EddieFranco/Home-Energy-Monitoring-Management-System/Images/Monitoring System block diagram.JPG

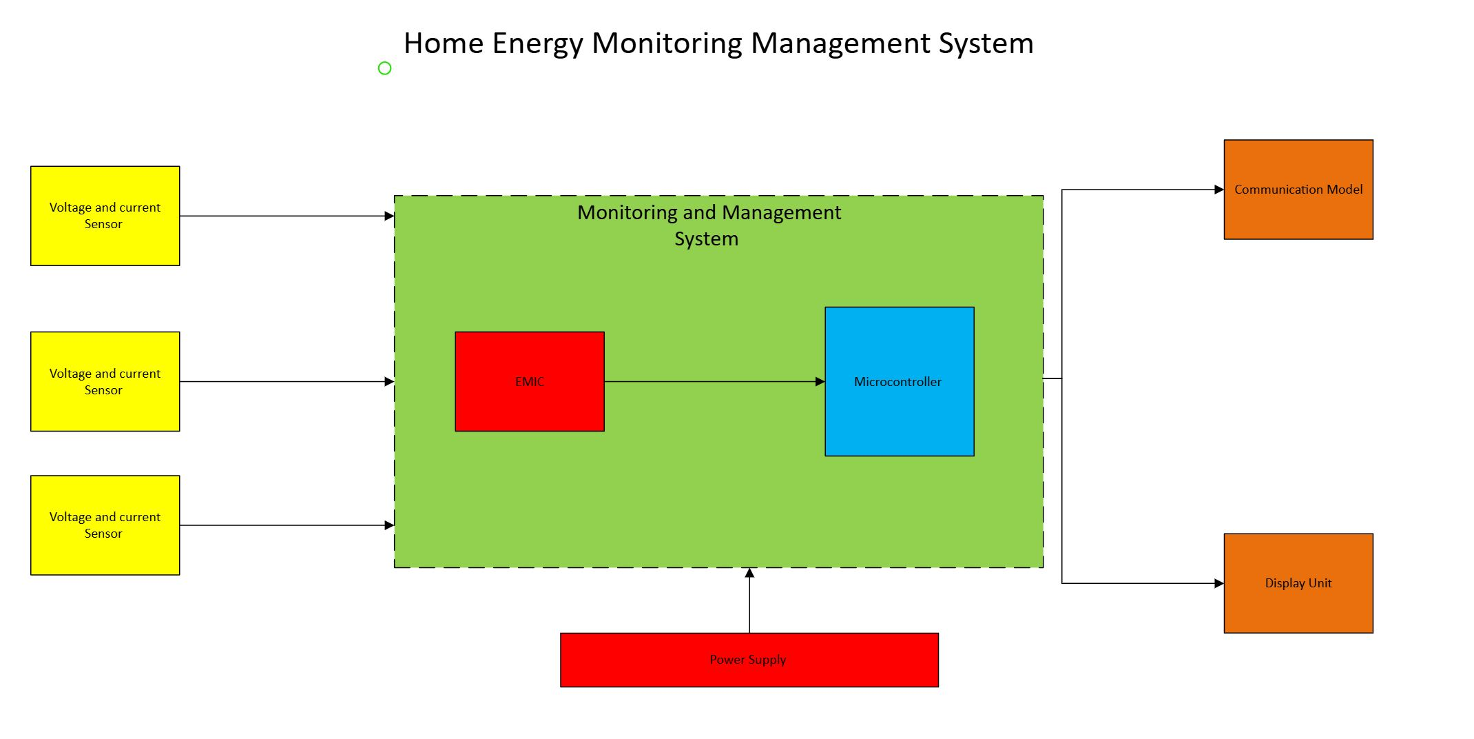
Images/Monitoring System block diagram.JPG
