EddieFranco/Home-Energy-Monitoring-Management-System/Water_Heat_Temp/Water_Heat_Temp.ioc

Mcu.UserName=STM32F407VGTx
PA0-WKUP.Signal=GPIO_Output
PA1.Signal=GPIO_Output
PB0.Signal=S_TIM3_CH3
PB1.Signal=S_TIM3_CH4
PB6.Signal=I2C1_SCL
PB7.Signal=I2C1_SDA
PD12.Signal=GPIO_Output
PD13.Signal=GPIO_Output
PD14.Signal=GPIO_Output
PD15.Signal=GPIO_Output
PD5.Signal=USART2_TX
PD6.Signal=USART2_RX
