EddieFranco/Home-Energy-Monitoring-Management-System/(commit log)

2025-10-21 output pcb project added
2025-10-21 water heater sources and header files
