EddieFranco/Home-Energy-Monitoring-Management-System/(notices)

Notices in the files:
Water_Heat_Temp/Core/Src/main.c:
Copyright (c) 2025 STMicroelectronics.
All rights reserved.
This software is licensed under terms that can be found in the LICENSE file
